akashihi/Project334/P1/pcb/SOD123-2_ONS.step

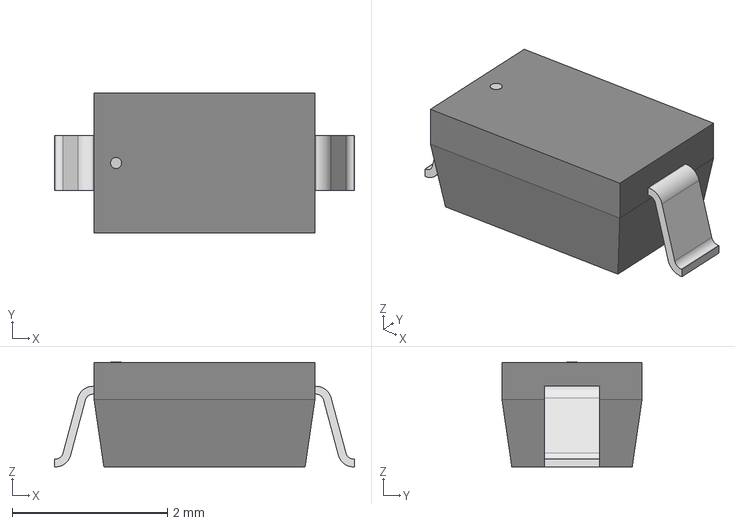
[picture p1: CAD file, 2024-09-19]
P1/pcb/SOD123-2_ONS.step
3.86 x 1.80 x 1.35 mm
