akashihi/Project334/P1/pcb/DC-10.STEP

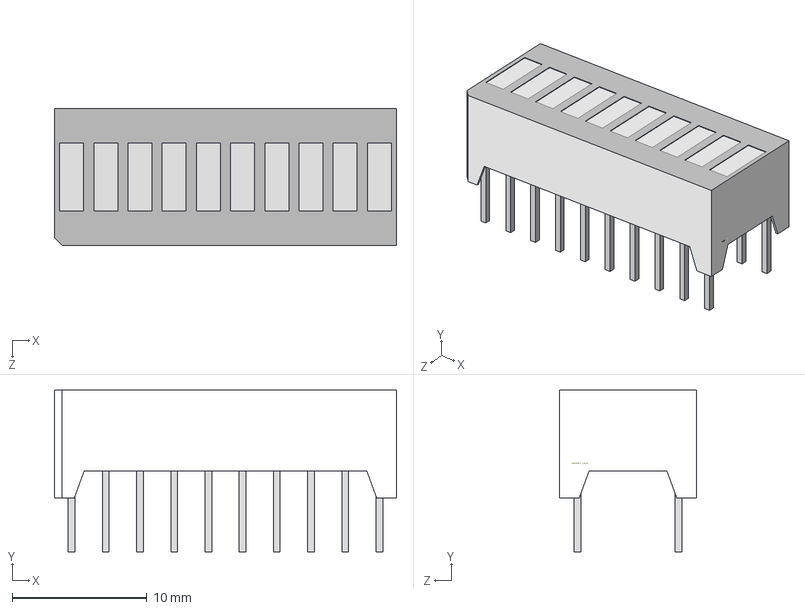
[picture p2: CAD file, 2024-09-19]
P1/pcb/DC-10.STEP
25.4 x 12.0 x 10.2 mm
