akashihi/Project334/P1/pcb/650473-5.step

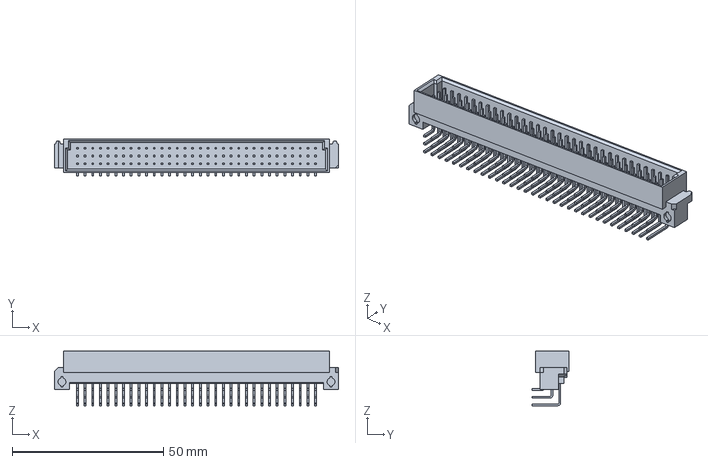
[picture p3: CAD file, 2024-09-19]
P1/pcb/650473-5.step
93.8 x 12.1 x 18.0 mm
