akashihi/Project334/P1/pcb/86093968124H55V1LF.STEP

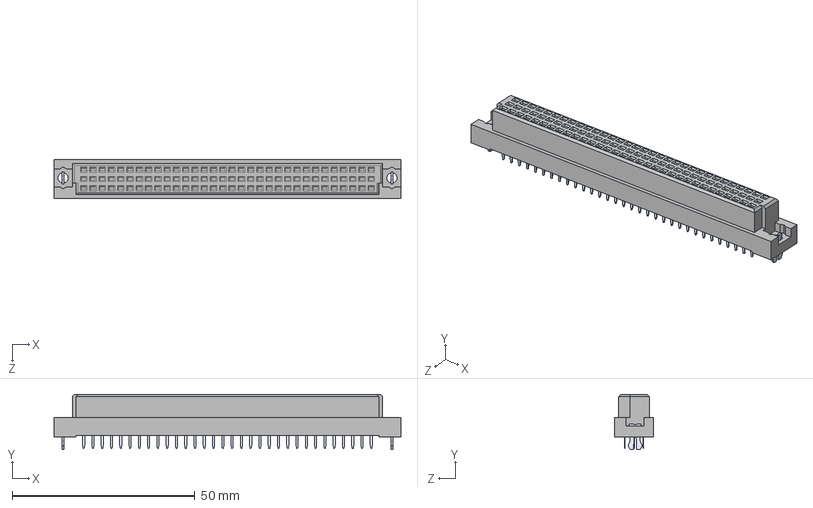
[picture p4: CAD file, 2024-09-19]
P1/pcb/86093968124H55V1LF.STEP
95.0 x 15.1 x 10.6 mm
