akashihi/Project334/(list of files, drawings)

Other design files:
P1/P1.circ
