akashihi/Project334/P1/pcb/alu_addsub/alu.kicad_pcb

## KiCad design P1/pcb/alu_addsub/alu.kicad_pcb (2025-02-13)

Schematic: alu.kicad_sch

Parts:
C1, C2, C3, C4, C5, C6, C7, C8, C9, C10, C13, C14, C23, C24, C25, C26: 100n; C_1206_3216Metric
J1: 650473-5; TE_650473-5; PARTREV S
U1, U4, U6, U9, U14, U15: 74HC86; TSSOP-14_4.4x5mm_P0.65mm
U2, U5, U7: 74LS08; TSSOP-14_4.4x5mm_P0.65mm
U3, U30: 74LS32; TSSOP-14_4.4x5mm_P0.65mm
U8: 74LS32
U10: 74LS08
U13: 74LS541; SOIC-20W_7.5x12.8mm_P1.27mm
U29: 74HC238; TSSOP-16_4.4x5mm_P0.65mm
U31: 74LS621; SOIC-20W_7.5x12.8mm_P1.27mm

Connections:
+5V: C1.1, C2.1, C3.1, C4.1, C5.1, C6.1, C7.1, C8.1, C9.1, C10.1, C13.1, C14.1, C23.1, C24.1, C25.1, C26.1, J1.A32, J1.C29, J1.C32, U1.14 (VCC), U2.14 (VCC), U3.14 (VCC), U4.14 (VCC), U5.14 (VCC), U6.14 (VCC), U7.14 (VCC), U8.14 (VCC), U9.14 (VCC), U10.14 (VCC), U13.20 (VCC), U14.14 (VCC), U15.14 (VCC), U29.16 (VCC), U30.14 (VCC), U31.19 (~GBA), U31.20 (VCC)
/RESULT0: U1.3, U31.2 (A0)
/RESULT1: U1.6, U31.3 (A1)
/RESULT2: U1.8, U31.4 (A2)
/RESULT3: U1.11, U31.5 (A3)
/RESULT4: U6.3, U31.6 (A4)
/RESULT5: U6.6, U31.7 (A5)
/RESULT6: U6.8, U31.8 (A6)
/RESULT7: U6.11, U31.9 (A7)
/T0: U2.5, U4.2, U15.3
/T1: U2.13, U4.5, U15.6
/T2: U4.10, U5.5, U15.8
/T3: U4.13, U5.13, U15.11
/T4: U7.5, U9.13, U14.3
/T5: U7.13, U9.10, U14.6
/T6: U9.5, U10.5, U14.8
/T7: U9.2, U14.11
/X_IN0: J1.A19, U31.18 (B0)
/X_IN1: J1.A20, U31.17 (B1)
/X_IN2: J1.A21, U31.16 (B2)
/X_IN3: J1.A22, U31.15 (B3)
/X_IN4: J1.A23, U31.14 (B4)
/X_IN5: J1.A24, U31.13 (B5)
/X_IN6: J1.A25, U31.12 (B6)
/X_IN7: J1.A26, U31.11 (B7)
/X_OUT0: U2.4, U4.1, U13.11 (Y7)
/X_OUT1: U2.12, U4.4, U13.12 (Y6)
/X_OUT2: U4.9, U5.4, U13.13 (Y5)
/X_OUT3: U4.12, U5.12, U13.14 (Y4)
/X_OUT4: U7.4, U9.12, U13.15 (Y3)
/X_OUT5: U7.12, U9.9, U13.16 (Y2)
/X_OUT6: U9.4, U10.4, U13.17 (Y1)
/X_OUT7: U9.1, U13.18 (Y0)
/Y_OUT0: J1.A10, U15.1
/Y_OUT1: J1.A11, U15.4
/Y_OUT2: J1.A12, U15.9
/Y_OUT3: J1.A13, U15.12
/Y_OUT4: J1.A14, U14.1
/Y_OUT5: J1.A15, U14.4
/Y_OUT6: J1.A16, U14.9
/Y_OUT7: J1.A17, U14.12
GND: C1.2, C2.2, C3.2, C4.2, C5.2, C6.2, C7.2, C8.2, C9.2, C10.2, C13.2, C14.2, C23.2, C24.2, C25.2, C26.2, J1.A9, J1.A18, J1.A27, J1.B6, J1.B15, J1.B24, J1.C5, J1.C10, J1.C17, J1.C26, J1.C28, J1.C30, U1.7 (GND), U2.7 (GND), U3.7 (GND), U4.7 (GND), U5.7 (GND), U6.7 (GND), U7.7 (GND), U8.7 (GND), U8.12, U8.13, U9.7 (GND), U10.7 (GND), U10.9, U10.10, U10.12, U10.13, U13.1 (G1), U13.10 (GND), U13.19 (G2), U14.7 (GND), U15.7 (GND), U29.4 (~E1), U29.5 (~E2), U29.8 (GND), U30.4, U30.5, U30.7 (GND), U30.9, U30.10, U30.12, U30.13, U31.10 (GND)
unnamed: U1.1, U2.2, U4.3
unnamed: U1.4, U2.10, U4.6
unnamed: U1.5, U2.9, U3.3
unnamed: U1.9, U4.8, U5.2
unnamed: U1.10, U3.6, U5.1
unnamed: U1.12, U4.11, U5.10
unnamed: U1.13, U3.8, U5.9
unnamed: U2.3, U3.1
unnamed: U2.6, U3.2
unnamed: U2.8, U3.4
unnamed: U2.11, U3.5
unnamed: U3.9, U5.3
unnamed: U3.10, U5.6
unnamed: U3.11, U6.2, U7.1
unnamed: U3.12, U5.8
unnamed: U3.13, U5.11
unnamed: U6.1, U7.2, U9.11
unnamed: U6.4, U7.10, U9.8
unnamed: U6.5, U7.9, U8.3
unnamed: U6.12, U9.3
unnamed: U6.13, U8.8
unnamed: U7.3, U8.1
unnamed: U7.6, U8.2
unnamed: U7.8, U8.4
unnamed: U7.11, U8.5
unnamed: U6.10, U8.6, U10.1
unnamed: U6.9, U9.6, U10.2
unnamed: U8.9, U10.3
unnamed: U8.10, U10.6
unnamed: J1.A8, U13.2 (A0)
unnamed: J1.A7, U13.3 (A1)
unnamed: J1.A6, U13.4 (A2)
unnamed: J1.A5, U13.5 (A3)
unnamed: J1.A4, U13.6 (A4)
unnamed: J1.A3, U13.7 (A5)
unnamed: J1.A2, U13.8 (A6)
unnamed: J1.A1, U13.9 (A7)
unnamed: J1.A31, U29.1 (A0)
unnamed: J1.A30, U29.2 (A1)
unnamed: J1.A29, U29.3 (A2)
unnamed: J1.A28, U29.6 (E3)
unnamed: U29.15 (Y0), U30.1
unnamed: U1.2, U2.1, U14.2, U14.5, U14.10, U14.13, U15.2, U15.5, U15.10, U15.13, U29.14 (Y1), U30.2
unnamed: U30.3, U31.1 (GAB)

Notes on the sheet:
Subtractor XORs decoupling
A0/B0 Adder
A7/B7 Adder
4-bit adder decoupling
A1/B1 Adder
2's complement
A5/B5 Adder
A6/B6 Adder
A2/B2 Adder
A3/B3 Adder
A4/B4 Adder

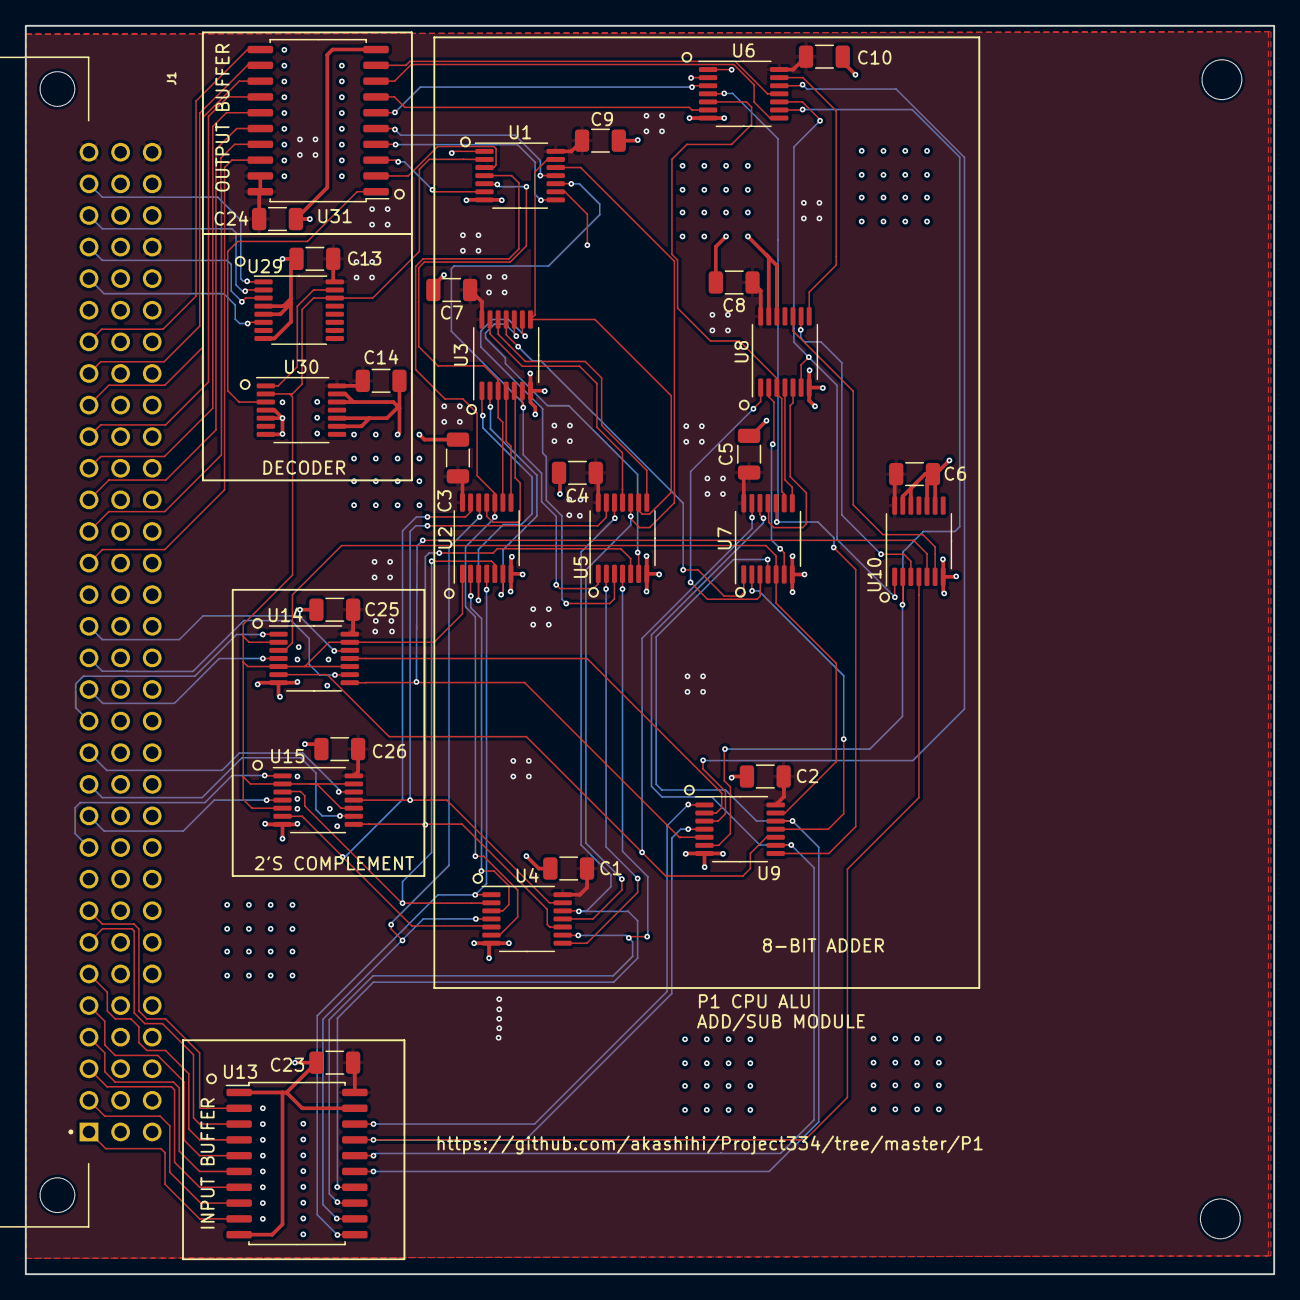
[picture p5: board P1/pcb/alu_addsub/alu.kicad_pcb from above]

Board: 4 copper layers, 100.3 x 100.3 mm, 33 parts (0 on the bottom side), 86 nets.
