akashihi/Project334/P1/pcb/alu_unary_op/alu.kicad_pcb

## KiCad design P1/pcb/alu_unary_op/alu.kicad_pcb (2025-02-13)

Schematic: alu.kicad_sch

Parts:
C1, C23, C24, C25, C26, C27, C28, C29, C30: 100n; C_1206_3216Metric
J1: 650473-5; TE_650473-5; PARTREV S
U13: 74LS541; SOIC-20W_7.5x12.8mm_P1.27mm
U23, U24: 74HC04; TSSOP-14_4.4x5mm_P0.65mm
U25, U28: 74LS621; SOIC-20W_7.5x12.8mm_P1.27mm
U26, U27: 74LS157; TSSOP-16_4.4x5mm_P0.65mm
U29: 74HC238; TSSOP-16_4.4x5mm_P0.65mm
U30: 74LS32; TSSOP-14_4.4x5mm_P0.65mm

Connections:
+5V: C1.1, C23.1, C24.1, C25.1, C26.1, C27.1, C28.1, C29.1, C30.1, J1.A32, J1.C29, J1.C32, U13.20 (VCC), U23.14 (VCC), U24.5, U24.9, U24.11, U24.13, U24.14 (VCC), U25.19 (~GBA), U25.20 (VCC), U26.16 (VCC), U27.16 (VCC), U28.19 (~GBA), U28.20 (VCC), U29.16 (VCC), U30.14 (VCC)
/X_IN0: J1.A19, U25.18 (B0), U28.18 (B0)
/X_IN1: J1.A20, U25.17 (B1), U28.17 (B1)
/X_IN2: J1.A21, U25.16 (B2), U28.16 (B2)
/X_IN3: J1.A22, U25.15 (B3), U28.15 (B3)
/X_IN4: J1.A23, U25.14 (B4), U28.14 (B4)
/X_IN5: J1.A24, U25.13 (B5), U28.13 (B5)
/X_IN6: J1.A25, U25.12 (B6), U28.12 (B6)
/X_IN7: J1.A26, U25.11 (B7), U28.11 (B7)
/X_OUT0: U13.11 (Y7), U23.5, U26.6 (I1b)
/X_OUT1: U13.12 (Y6), U23.3, U26.2 (I0a), U26.10 (I1c)
/X_OUT2: U13.13 (Y5), U23.1, U26.5 (I0b), U26.13 (I1d)
/X_OUT3: U13.14 (Y4), U23.9, U26.11 (I0c), U27.3 (I1a)
/X_OUT4: U13.15 (Y3), U23.11, U26.14 (I0d), U27.6 (I1b)
/X_OUT5: U13.16 (Y2), U23.13, U27.2 (I0a), U27.10 (I1c)
/X_OUT6: U13.17 (Y1), U24.3, U27.5 (I0b), U27.13 (I1d)
/X_OUT7: U13.18 (Y0), U24.1, U27.11 (I0c)
GND: C1.2, C23.2, C24.2, C25.2, C26.2, C27.2, C28.2, C29.2, C30.2, J1.A9, J1.A18, J1.A27, J1.B6, J1.B15, J1.B24, J1.C5, J1.C10, J1.C17, J1.C26, J1.C28, J1.C30, U13.1 (G1), U13.10 (GND), U13.19 (G2), U23.7 (GND), U24.7 (GND), U25.10 (GND), U26.3 (I1a), U26.8 (GND), U26.15 (E), U27.8 (GND), U27.14 (I0d), U27.15 (E), U28.10 (GND), U29.4 (~E1), U29.5 (~E2), U29.8 (GND), U30.1, U30.2, U30.7 (GND), U30.9, U30.10, U30.12, U30.13
unnamed: J1.A8, U13.2 (A0)
unnamed: J1.A7, U13.3 (A1)
unnamed: J1.A6, U13.4 (A2)
unnamed: J1.A5, U13.5 (A3)
unnamed: J1.A4, U13.6 (A4)
unnamed: J1.A3, U13.7 (A5)
unnamed: J1.A2, U13.8 (A6)
unnamed: J1.A1, U13.9 (A7)
unnamed: U23.6, U25.2 (A0)
unnamed: U23.4, U25.3 (A1)
unnamed: U23.2, U25.4 (A2)
unnamed: U23.8, U25.5 (A3)
unnamed: U23.10, U25.6 (A4)
unnamed: U23.12, U25.7 (A5)
unnamed: U24.4, U25.8 (A6)
unnamed: U24.2, U25.9 (A7)
unnamed: U25.1 (GAB), U29.10 (Y5)
unnamed: U26.1 (S), U27.1 (S), U29.13 (Y2), U30.4
unnamed: U26.4 (Za), U28.2 (A0)
unnamed: U26.7 (Zb), U28.3 (A1)
unnamed: U26.9 (Zc), U28.4 (A2)
unnamed: U26.12 (Zd), U28.5 (A3)
unnamed: U27.4 (Za), U28.6 (A4)
unnamed: U27.7 (Zb), U28.7 (A5)
unnamed: U27.9 (Zc), U28.8 (A6)
unnamed: U27.12 (Zd), U28.9 (A7)
unnamed: U28.1 (GAB), U30.6
unnamed: J1.A31, U29.1 (A0)
unnamed: J1.A30, U29.2 (A1)
unnamed: J1.A29, U29.3 (A2)
unnamed: J1.A28, U29.6 (E3)
unnamed: U29.12 (Y3), U30.5

Notes on the sheet:
L/R SHIFT OP
NOT OP

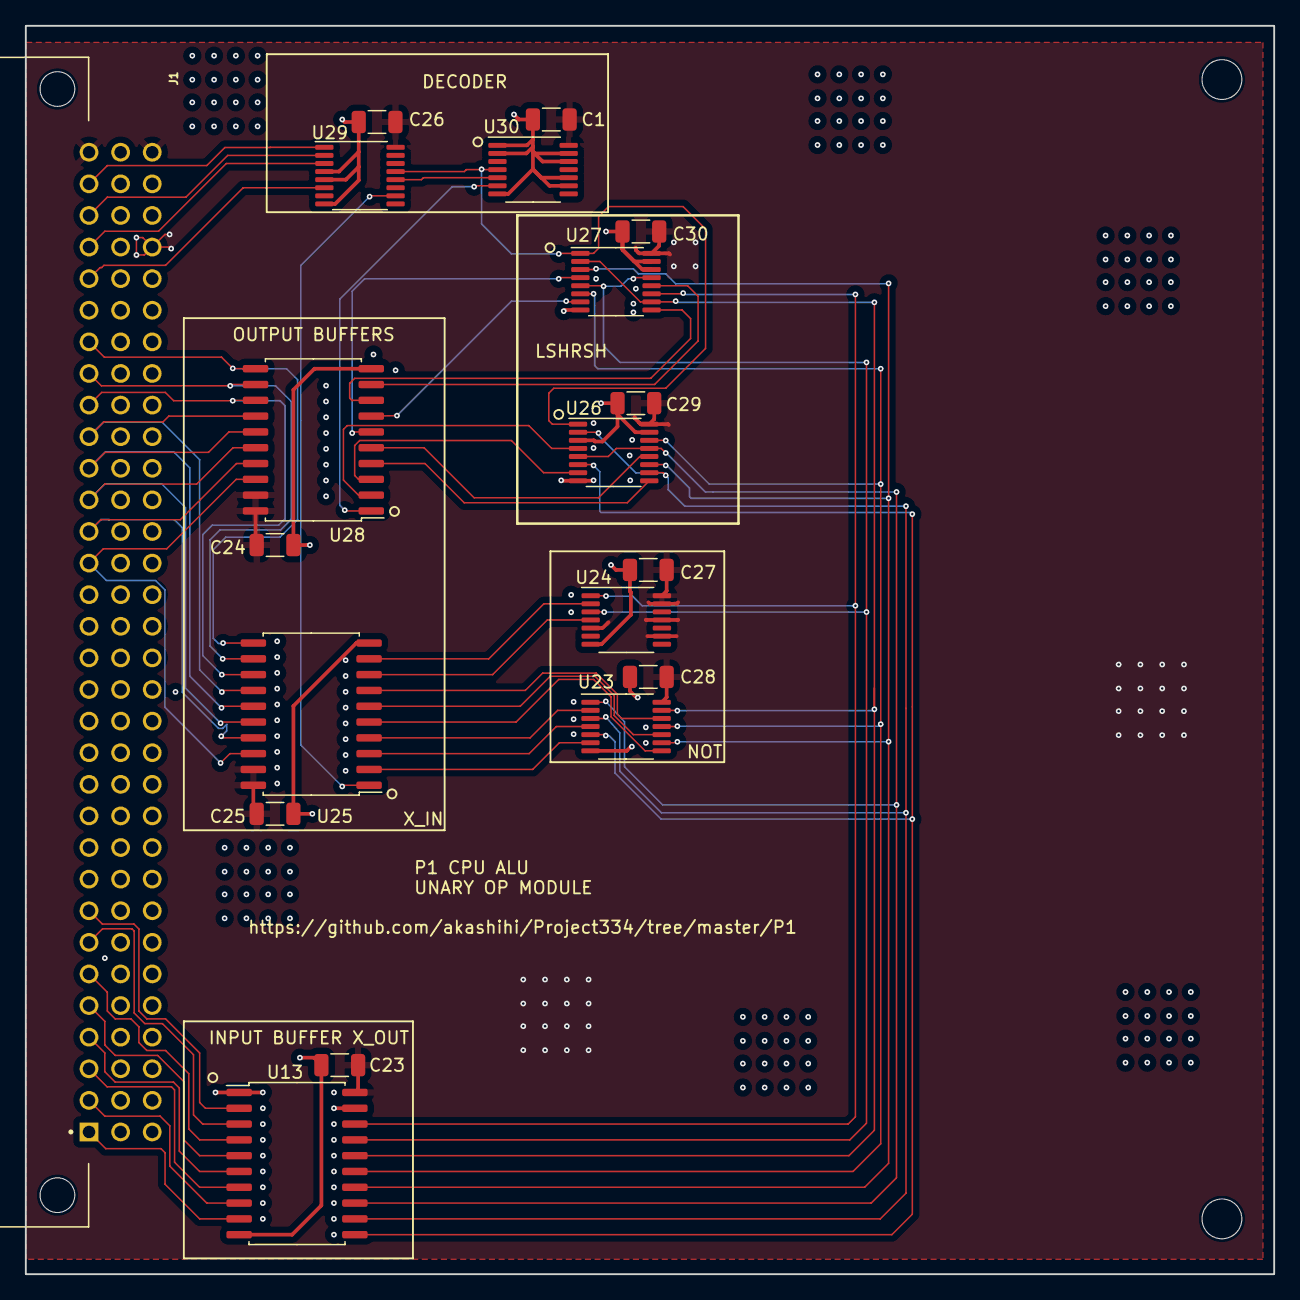
[picture p6: board P1/pcb/alu_unary_op/alu.kicad_pcb from above]

Board: 4 copper layers, 100.3 x 100.3 mm, 19 parts (0 on the bottom side), 50 nets.
