akashihi/Project334/P1/pcb/alu_binary_op/alu.kicad_pcb

## KiCad design P1/pcb/alu_binary_op/alu.kicad_pcb (2025-02-13)

Schematic: alu.kicad_sch

Parts:
C13, C14, C15, C23, C24, C25, C26, C27, C28, C29, C30: 100n; C_1206_3216Metric
J1: 650473-5; TE_650473-5; PARTREV S
U13: 74LS541; SOIC-20W_7.5x12.8mm_P1.27mm
U14, U15: 74HC86; TSSOP-14_4.4x5mm_P0.65mm
U16, U19, U22: 74LS621; SOIC-20W_7.5x12.8mm_P1.27mm
U17, U18: 74LS08; TSSOP-14_4.4x5mm_P0.65mm
U20, U21: 74LS32; TSSOP-14_4.4x5mm_P0.65mm
U29: 74HC238; TSSOP-16_4.4x5mm_P0.65mm

Connections:
+5V: C13.1, C14.1, C15.1, C23.1, C24.1, C25.1, C26.1, C27.1, C28.1, C29.1, C30.1, J1.A32, J1.C29, J1.C32, U13.20 (VCC), U14.14 (VCC), U15.14 (VCC), U16.19 (~GBA), U16.20 (VCC), U17.14 (VCC), U18.14 (VCC), U19.19 (~GBA), U19.20 (VCC), U20.14 (VCC), U21.14 (VCC), U22.19 (~GBA), U22.20 (VCC), U29.16 (VCC)
/X_IN0: J1.A19, U16.18 (B0), U19.18 (B0), U22.18 (B0)
/X_IN1: J1.A20, U16.17 (B1), U19.17 (B1), U22.17 (B1)
/X_IN2: J1.A21, U16.16 (B2), U19.16 (B2), U22.16 (B2)
/X_IN3: J1.A22, U16.15 (B3), U19.15 (B3), U22.15 (B3)
/X_IN4: J1.A23, U16.14 (B4), U19.14 (B4), U22.14 (B4)
/X_IN5: J1.A24, U16.13 (B5), U19.13 (B5), U22.13 (B5)
/X_IN6: J1.A25, U16.12 (B6), U19.12 (B6), U22.12 (B6)
/X_IN7: J1.A26, U16.11 (B7), U19.11 (B7), U22.11 (B7)
/X_OUT0: U13.11 (Y7), U14.4, U17.5, U20.5
/X_OUT1: U13.12 (Y6), U14.1, U17.2, U20.2
/X_OUT2: U13.13 (Y5), U14.9, U17.10, U20.10
/X_OUT3: U13.14 (Y4), U14.12, U17.13, U20.13
/X_OUT4: U13.15 (Y3), U15.4, U18.5, U21.5
/X_OUT5: U13.16 (Y2), U15.1, U18.2, U21.2
/X_OUT6: U13.17 (Y1), U15.9, U18.10, U21.10
/X_OUT7: U13.18 (Y0), U15.12, U18.13, U21.13
/Y_OUT0: J1.A10, U14.5, U17.4, U20.4
/Y_OUT1: J1.A11, U14.2, U17.1, U20.1
/Y_OUT2: J1.A12, U14.10, U17.9, U20.9
/Y_OUT3: J1.A13, U14.13, U17.12, U20.12
/Y_OUT4: J1.A14, U15.5, U18.4, U21.4
/Y_OUT5: J1.A15, U15.2, U18.1, U21.1
/Y_OUT6: J1.A16, U15.10, U18.9, U21.9
/Y_OUT7: J1.A17, U15.13, U18.12, U21.12
GND: C13.2, C14.2, C15.2, C23.2, C24.2, C25.2, C26.2, C27.2, C28.2, C29.2, C30.2, J1.A9, J1.A18, J1.A27, J1.B6, J1.B15, J1.B24, J1.C5, J1.C10, J1.C17, J1.C26, J1.C28, J1.C30, U13.1 (G1), U13.10 (GND), U13.19 (G2), U14.7 (GND), U15.7 (GND), U16.10 (GND), U17.7 (GND), U18.7 (GND), U19.10 (GND), U20.7 (GND), U21.7 (GND), U22.10 (GND), U29.4 (~E1), U29.5 (~E2), U29.8 (GND)
unnamed: J1.A8, U13.2 (A0)
unnamed: J1.A7, U13.3 (A1)
unnamed: J1.A6, U13.4 (A2)
unnamed: J1.A5, U13.5 (A3)
unnamed: J1.A4, U13.6 (A4)
unnamed: J1.A3, U13.7 (A5)
unnamed: J1.A2, U13.8 (A6)
unnamed: J1.A1, U13.9 (A7)
unnamed: U14.6, U16.2 (A0)
unnamed: U14.3, U16.3 (A1)
unnamed: U14.8, U16.4 (A2)
unnamed: U14.11, U16.5 (A3)
unnamed: U15.6, U16.6 (A4)
unnamed: U15.3, U16.7 (A5)
unnamed: U15.8, U16.8 (A6)
unnamed: U15.11, U16.9 (A7)
unnamed: U16.1 (GAB), U29.11 (Y4)
unnamed: U17.6, U19.2 (A0)
unnamed: U17.3, U19.3 (A1)
unnamed: U17.8, U19.4 (A2)
unnamed: U17.11, U19.5 (A3)
unnamed: U18.6, U19.6 (A4)
unnamed: U18.3, U19.7 (A5)
unnamed: U18.8, U19.8 (A6)
unnamed: U18.11, U19.9 (A7)
unnamed: U19.1 (GAB), U29.9 (Y6)
unnamed: U20.6, U22.2 (A0)
unnamed: U20.3, U22.3 (A1)
unnamed: U20.8, U22.4 (A2)
unnamed: U20.11, U22.5 (A3)
unnamed: U21.6, U22.6 (A4)
unnamed: U21.3, U22.7 (A5)
unnamed: U21.8, U22.8 (A6)
unnamed: U21.11, U22.9 (A7)
unnamed: U22.1 (GAB), U29.7 (Y7)
unnamed: J1.A31, U29.1 (A0)
unnamed: J1.A30, U29.2 (A1)
unnamed: J1.A29, U29.3 (A2)
unnamed: J1.A28, U29.6 (E3)

Notes on the sheet:
OR OP
XOR OP
AND OP

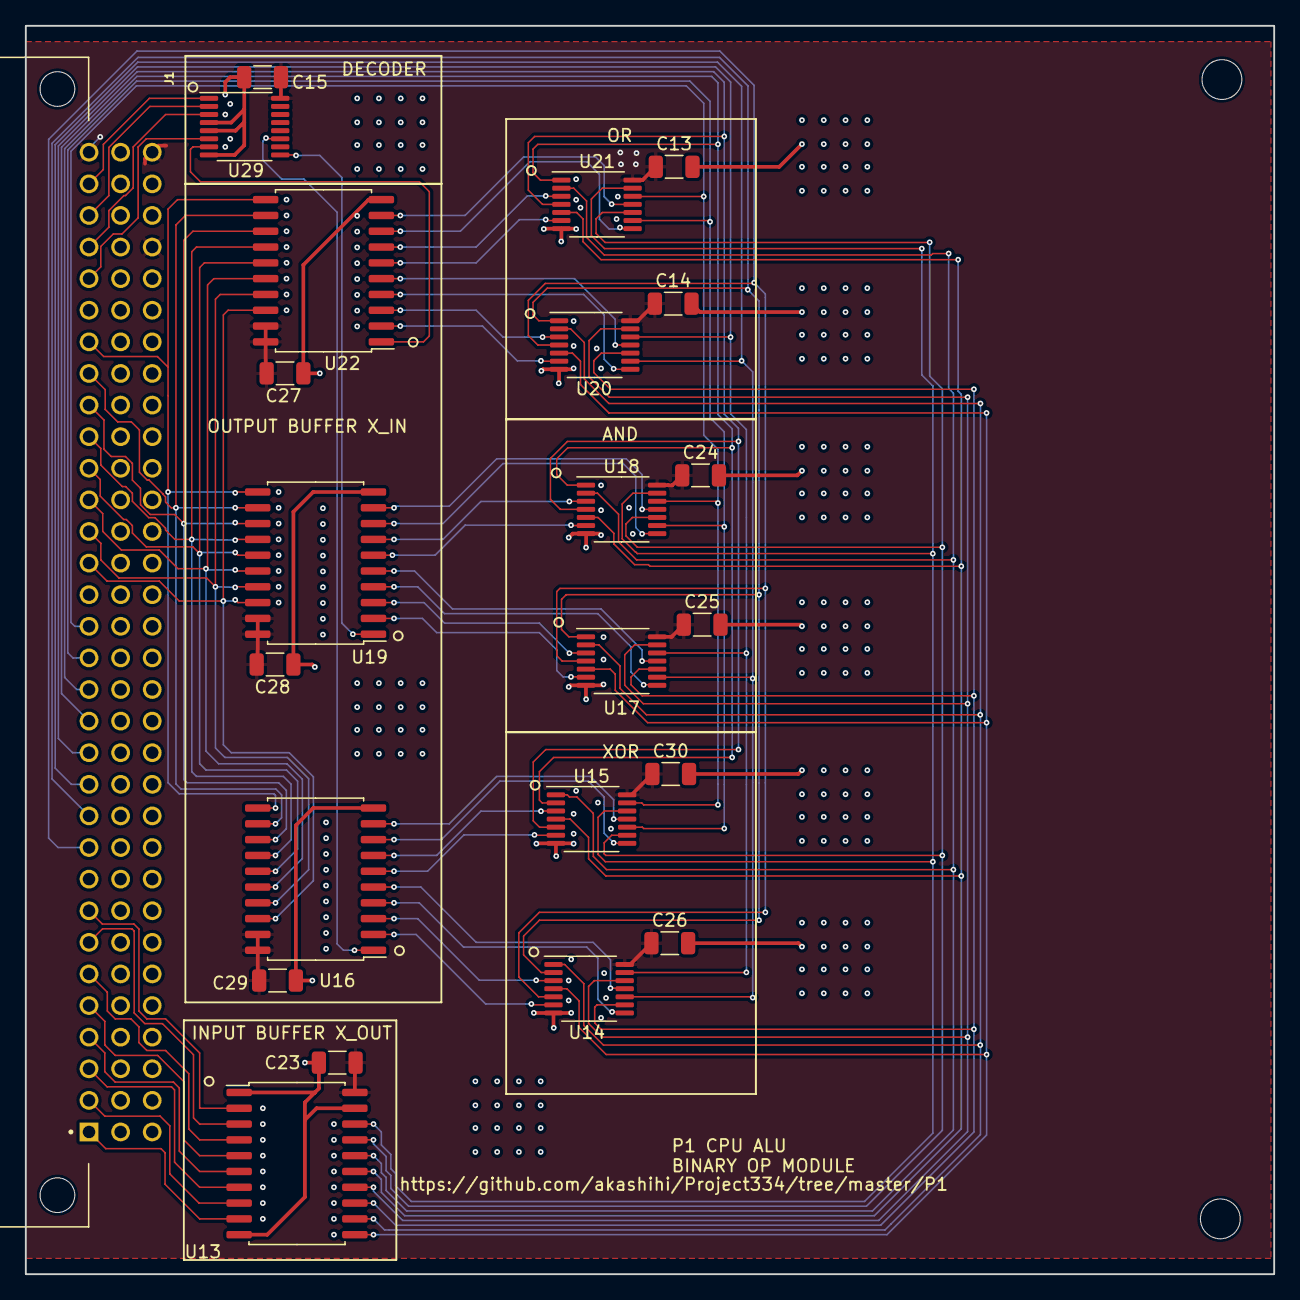
[picture p7: board P1/pcb/alu_binary_op/alu.kicad_pcb from above]

Board: 4 copper layers, 100.3 x 100.3 mm, 23 parts (0 on the bottom side), 65 nets.
