akashihi/Project334/P1/pcb/breakout/breakout.kicad_pcb

## KiCad design P1/pcb/breakout/breakout.kicad_pcb (2024-09-19)

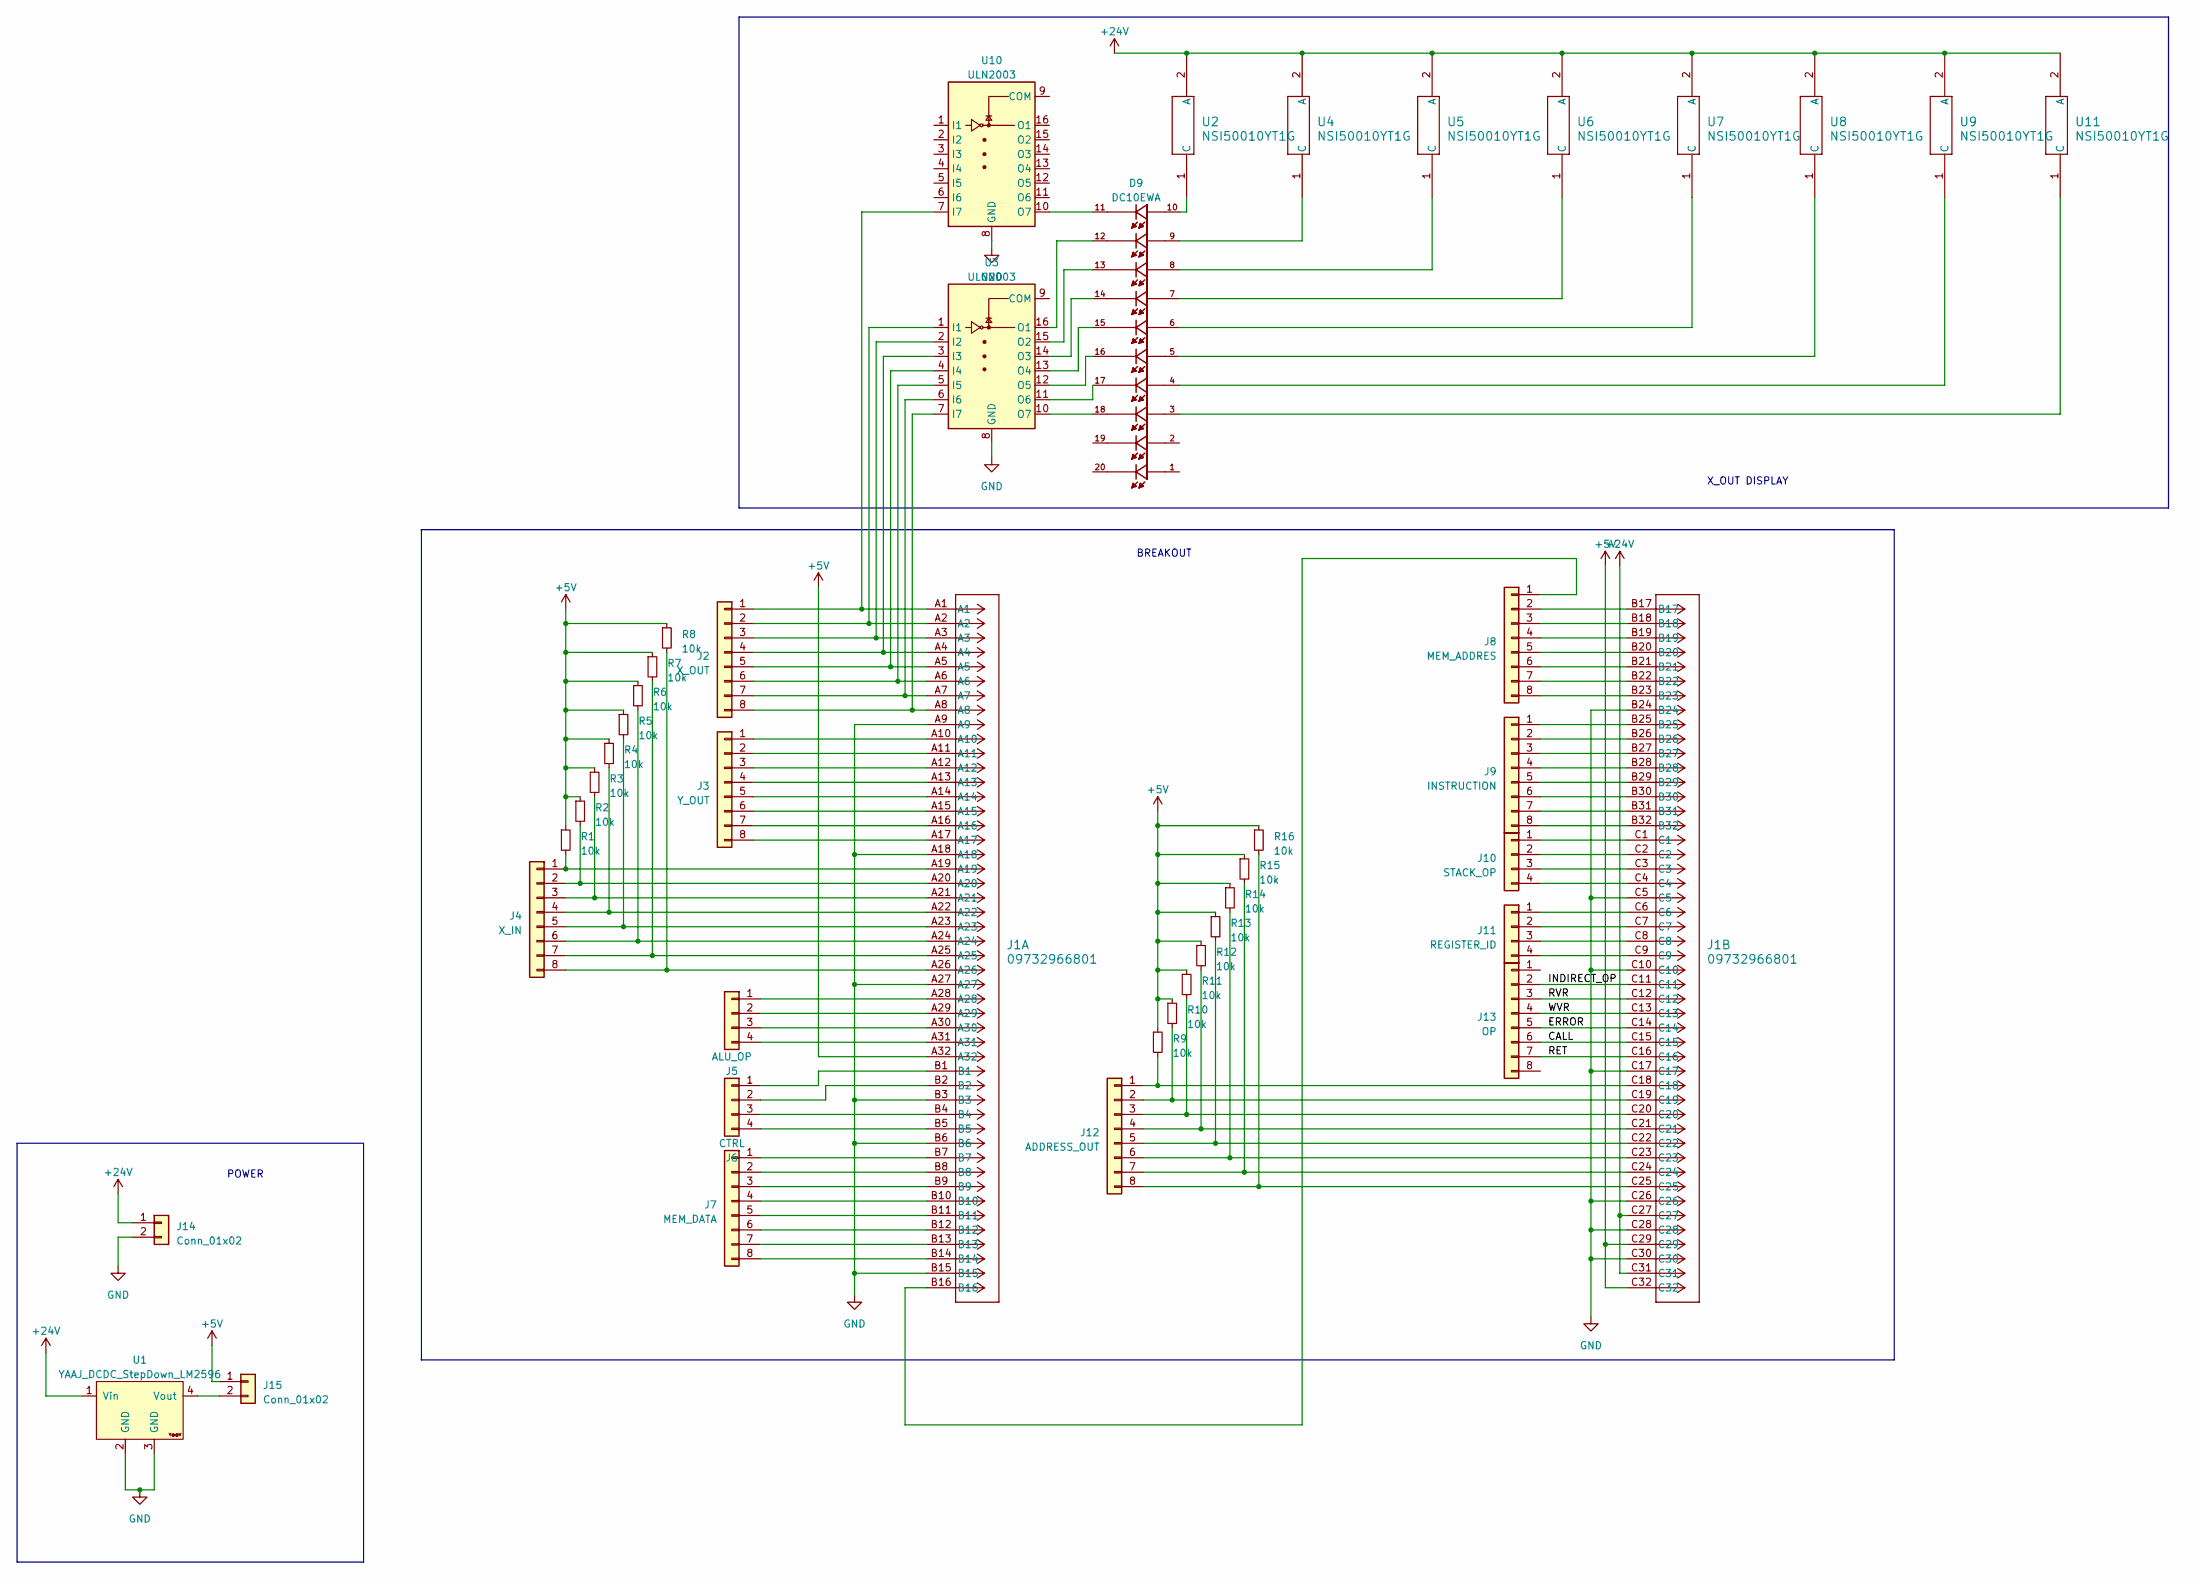
[picture p8: schematic breakout.kicad_sch]

Parts:
D9: DC10EWA; DIP750W50P254L2540H825Q20; PARTREV V.10A
J1: 09732966801; DIN41612_C_3x32_Female_Vertical_THT
J2: X_OUT; PinHeader_1x08_P2.54mm_Vertical
J3: Y_OUT; PinHeader_1x08_P2.54mm_Vertical
J4: X_IN; PinHeader_1x08_P2.54mm_Vertical
J5: ALU_OP; PinHeader_1x04_P2.54mm_Vertical
J6: CTRL; PinHeader_1x04_P2.54mm_Vertical
J7: MEM_DATA; PinHeader_1x08_P2.54mm_Vertical
J8: MEM_ADDRES; PinHeader_1x08_P2.54mm_Vertical
J9: INSTRUCTION; PinHeader_1x08_P2.54mm_Vertical
J10: STACK_OP; PinHeader_1x04_P2.54mm_Vertical
J11: REGISTER_ID; PinHeader_1x04_P2.54mm_Vertical
J12: ADDRESS_OUT; PinHeader_1x08_P2.54mm_Vertical
J13: OP; PinHeader_1x08_P2.54mm_Vertical
J14, J15: Conn_01x02; PinHeader_1x02_P2.54mm_Vertical
R1, R2, R3, R4, R5, R6, R7, R8, R9, R10, R11, R12, R13, R14, R15, R16: 10k; R_0805_2012Metric_Pad1.20x1.40mm_HandSolder
U1: YAAJ_DCDC_StepDown_LM2596
U2, U4, U5, U6, U7, U8, U9, U11: NSI50010YT1G; SOD123-2_ONS
U3, U10: ULN2003; TSSOP-16-1EP_4.4x5mm_P0.65mm

Connections:
+5V: J1.A32, J1.C29, J1.C32, J15.1, R1.1, R2.1, R3.1, R4.1, R5.1, R6.1, R7.1, R8.1, R9.1, R10.1, R11.1, R12.1, R13.1, R14.1, R15.1, R16.1
+24V: J1.C27, J1.C31, J14.1, U1.1 (Vin), U2.2 (A), U4.2 (A), U5.2 (A), U6.2 (A), U7.2 (A), U8.2 (A), U9.2 (A), U11.2 (A)
/CALL: J1.C15, J13.6
/ERROR: J1.C14, J13.5
/INDIRECT_OP: J1.C11, J13.2
/RET: J1.C16, J13.7
/RVR: J1.C12, J13.3
/WVR: J1.C13, J13.4
GND: J1.A9, J1.A18, J1.A27, J1.B3, J1.B6, J1.B15, J1.B24, J1.C5, J1.C10, J1.C17, J1.C26, J1.C28, J1.C30, J14.2, U1.2 (GND), U1.3 (GND), U3.8 (GND), U10.8 (GND)
unnamed: J1.A1, J2.1, U10.7 (I7)
unnamed: J1.A2, J2.2, U3.1 (I1)
unnamed: J1.A3, J2.3, U3.2 (I2)
unnamed: J1.A4, J2.4, U3.3 (I3)
unnamed: J1.A5, J2.5, U3.4 (I4)
unnamed: J1.A6, J2.6, U3.5 (I5)
unnamed: J1.A7, J2.7, U3.6 (I6)
unnamed: J1.A8, J2.8, U3.7 (I7)
unnamed: J1.A10, J3.1
unnamed: J1.A11, J3.2
unnamed: J1.A12, J3.3
unnamed: J1.A13, J3.4
unnamed: J1.A14, J3.5
unnamed: J1.A15, J3.6
unnamed: J1.A16, J3.7
unnamed: J1.A17, J3.8
unnamed: J1.A19, J4.1, R1.2
unnamed: J1.A20, J4.2, R2.2
unnamed: J1.A21, J4.3, R3.2
unnamed: J1.A22, J4.4, R4.2
unnamed: J1.A23, J4.5, R5.2
unnamed: J1.A24, J4.6, R6.2
unnamed: J1.A25, J4.7, R7.2
unnamed: J1.A26, J4.8, R8.2
unnamed: J1.A28, J5.1
unnamed: J1.A29, J5.2
unnamed: J1.A30, J5.3
unnamed: J1.A31, J5.4
unnamed: J1.B1, J6.1
unnamed: J1.B2, J6.2
unnamed: J1.B4, J6.3
unnamed: J1.B5, J6.4
unnamed: J1.B7, J7.1
unnamed: J1.B8, J7.2
unnamed: J1.B9, J7.3
unnamed: J1.B10, J7.4
unnamed: J1.B11, J7.5
unnamed: J1.B12, J7.6
unnamed: J1.B13, J7.7
unnamed: J1.B14, J7.8
unnamed: J1.B16, J8.1
unnamed: J1.B17, J8.2
unnamed: J1.B18, J8.3
unnamed: J1.B19, J8.4
unnamed: J1.B20, J8.5
unnamed: J1.B21, J8.6
unnamed: J1.B22, J8.7
unnamed: J1.B23, J8.8
unnamed: J1.B25, J9.1
unnamed: J1.B26, J9.2
unnamed: J1.B27, J9.3
unnamed: J1.B28, J9.4
unnamed: J1.B29, J9.5
unnamed: J1.B30, J9.6
unnamed: J1.B31, J9.7
unnamed: J1.B32, J9.8
unnamed: J1.C1, J10.1
unnamed: J1.C2, J10.2
unnamed: J1.C3, J10.3
unnamed: J1.C4, J10.4
unnamed: J1.C6, J11.1
unnamed: J1.C7, J11.2
unnamed: J1.C8, J11.3
unnamed: J1.C9, J11.4
unnamed: J1.C18, J12.1, R9.2
unnamed: J1.C19, J12.2, R10.2
unnamed: J1.C20, J12.3, R11.2
unnamed: J1.C21, J12.4, R12.2
unnamed: J1.C22, J12.5, R13.2
unnamed: J1.C23, J12.6, R14.2
unnamed: J1.C24, J12.7, R15.2
unnamed: J1.C25, J12.8, R16.2
unnamed: J15.2, U1.4 (Vout)
unnamed: D9.10, U2.1 (C)
unnamed: D9.12, U3.16 (O1)
unnamed: D9.13, U3.15 (O2)
unnamed: D9.14, U3.14 (O3)
unnamed: D9.15, U3.13 (O4)
unnamed: D9.16, U3.12 (O5)
unnamed: D9.17, U3.11 (O6)
unnamed: D9.18, U3.10 (O7)
unnamed: D9.9, U4.1 (C)
unnamed: D9.8, U5.1 (C)
unnamed: D9.7, U6.1 (C)
unnamed: D9.6, U7.1 (C)
unnamed: D9.5, U8.1 (C)
unnamed: D9.4, U9.1 (C)
unnamed: D9.11, U10.10 (O7)
unnamed: D9.3, U11.1 (C)

Notes on the sheet:
X_OUT DISPLAY
BREAKOUT
POWER

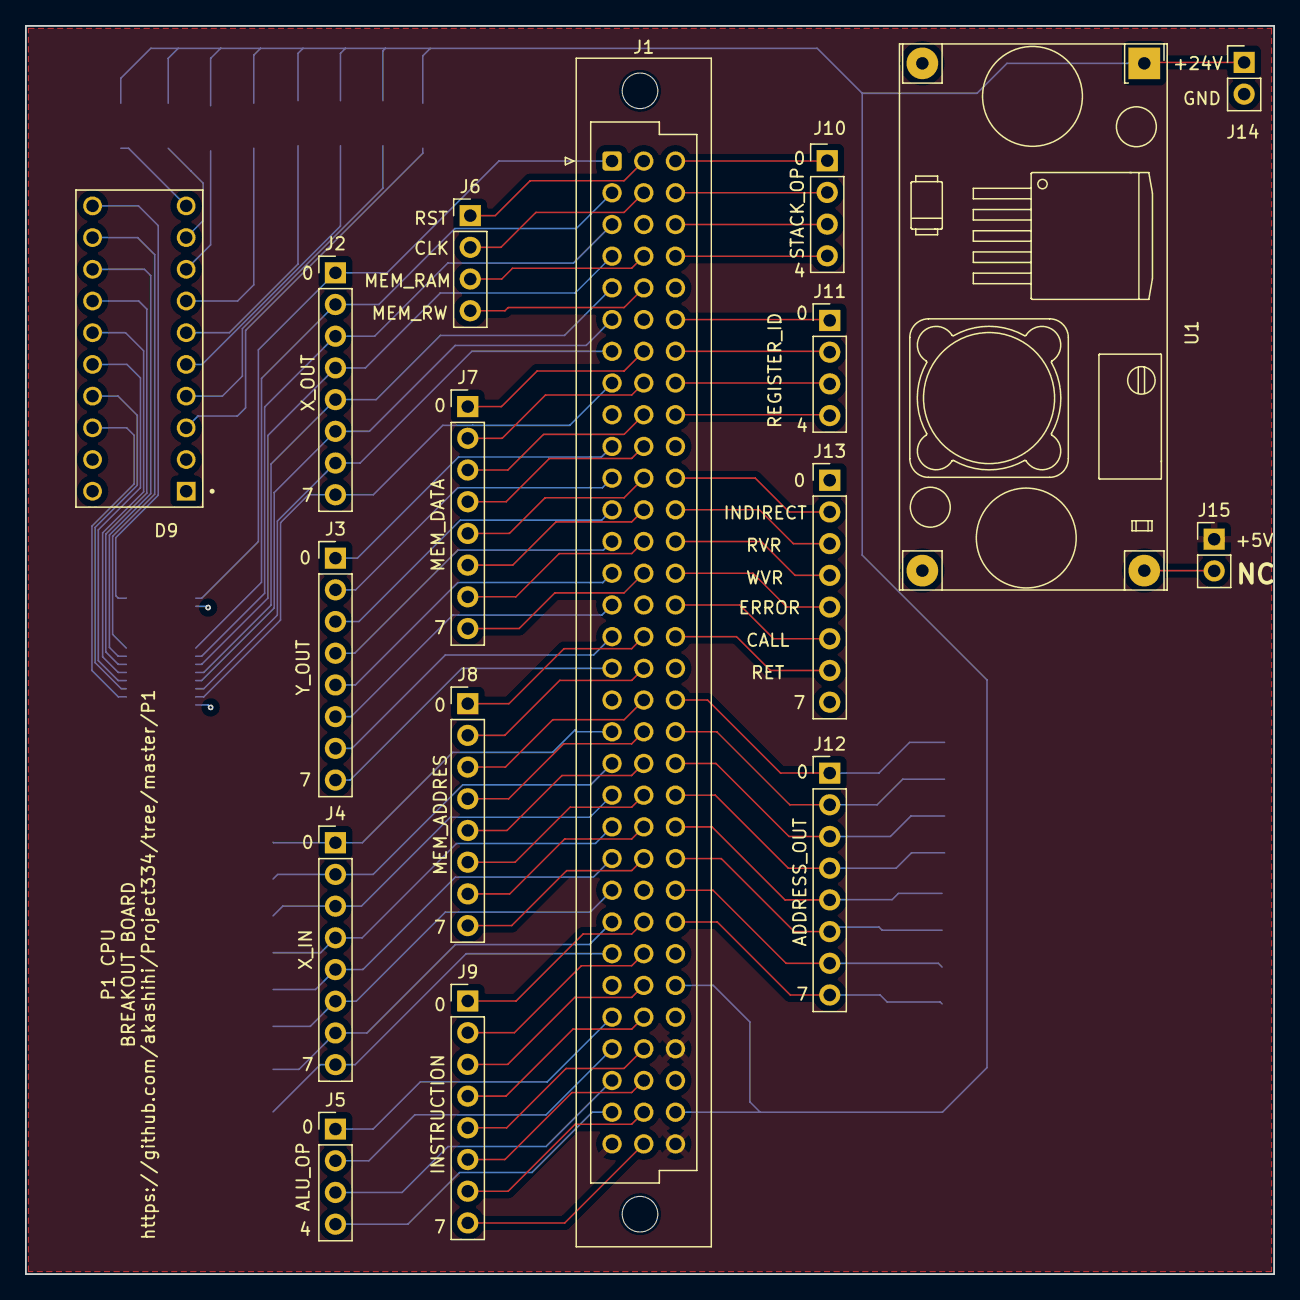
[picture p9: board breakout.kicad_pcb from above]

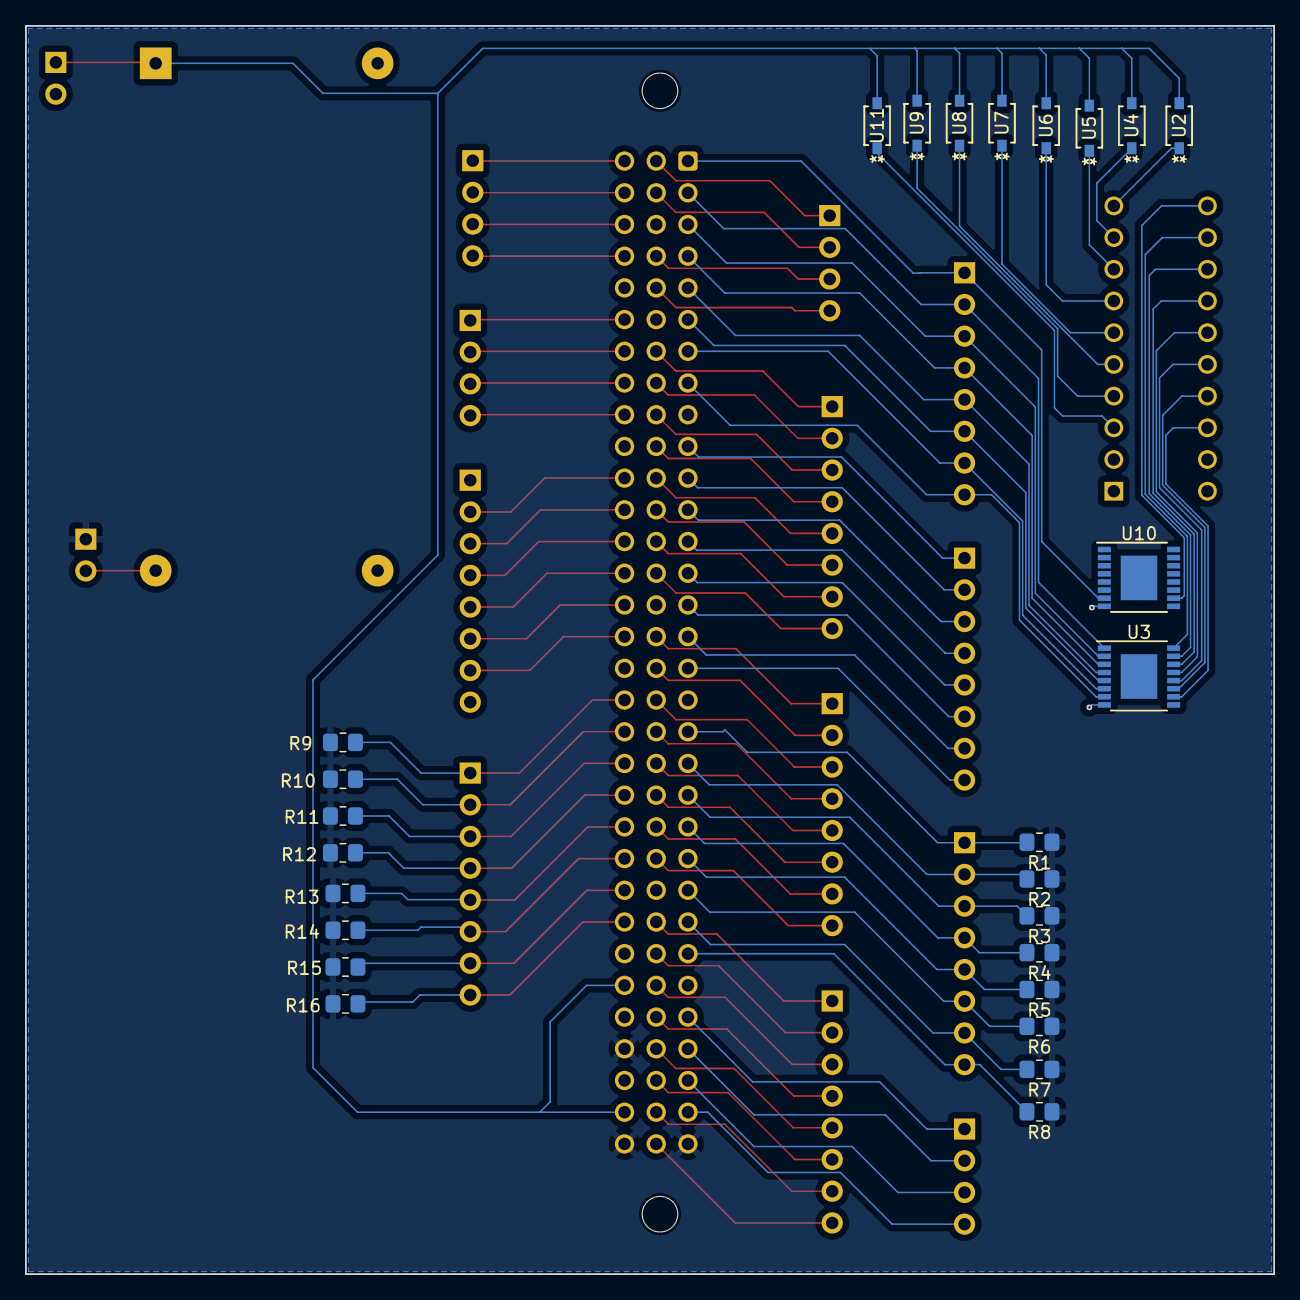
[picture p10: board breakout.kicad_pcb from below]

Board: 4 copper layers, 100.0 x 100.0 mm, 43 parts (26 on the bottom side), 98 nets.
