akashihi/Project334/(commit log)

2023-07-29 Added simple assembly tool for P1 ISA.
2023-07-29 Updates to follow fixed ISA.
    [main.rs]
2023-07-30 Added smoke tests and errors found during testing.
    [cpu.rs, main.rs]
2023-08-18 Added ALU logical circuit
    [P1.circ]
2023-08-24 Swapped X_IN and X_OUT in the ALU module
    [P1.circ]
2023-08-31 Added register file circuit
    [P1.circ]
2023-09-03 Fixed ALU inputs and testbench.
    [P1.circ]
2023-09-15 Added Memory interface, Fetch, Branching and CallStack modules
    [P1.circ]
2023-09-21 Added decoder module, CPU is ready.
    [P1.circ]
2023-09-22 Fixed incorrect instruction mapping
    [cpu.rs, main.rs]
2023-09-22 Fixed incorrect ALU connection
    [P1.circ]
2023-09-22 Fixed CALL/RET execution
    [P1.circ]
2023-09-30 Added (incomplete) README.
    [P1.circ]
2023-12-26 Fixed the overflow in register access.
    [cpu.rs]
2024-01-16 Added break out board for PCB modules debugging/testing
    [breakout.kicad_pcb, breakout.kicad_sch]
2024-09-19 ALU design complete
    [650473-5.step, 86093968124H55V1LF.STEP, AddSub.kicad_sch, DC-10.STEP, EightBitAdder.kicad_sch, SOD123-2_ONS.step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]
2024-09-19 Split ALU into 3 modules
    [P1.circ]
2024-10-10 Added circuit desigh for the stack
    [AddSub.kicad_sch, EightBitAdder.kicad_sch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]
2025-02-13 Swapped LSH and RSH
    [P1.circ]
2025-02-13 Removed unneeded backup files
    [alu-B_Cu.gbr, alu-B_Mask.gbr, alu-B_Paste.gbr, alu-B_Silkscreen.gbr, alu-Edge_Cuts.gbr, alu-F_Cu.gbr, alu-F_Mask.gbr, alu-F_Paste.gbr]
